FrediWa/taishou/(commit log)

2025-01-28 working two button keyboard with momentary layer
2025-04-09 Change last row pin from GP23 to GP13
2025-08-30 Use OpenSCAD for top
    [plate.scad]
2025-08-30 Fix SVG import
    [plate.scad]
2025-08-30 Refactor plate and create bottom
    [bottom_plate.scad, kb.scad, plate.scad, top_plate.scad]
2025-09-22 set 16mm square hole and export updated svg
    [top_plate.scad]
